glydrfreak/OpenPPG-SP-Throttle-EagleCAD/README.md

# OpenPPG-SP-Throttle-EagleCAD
Eagle CAD files for the OpenPPG Single Prop unit
