glydrfreak/OpenPPG-SP-Throttle-EagleCAD/BOM MAIN BOARD.xlsx

Qty | Value | Device | Package | Parts | Description | MPN
2 | 6.8pf | C-USC0402 | C0402 | C2, C4 | CAP CER 6.8PF 25V C0G/NP0 0402 | ‎GRM1555C1E6R8CA01D‎
2 | 1uf | C-USC0402 | C0402 | C3, C15 | CAP CER 1UF 25V X5R 0402 | GRM155R61E105KA12D‎
9 | .1uf | C-USC0402 | C0402 | C5, C6, C7, C10, C11, C12, C14, C17, C20 | CAP CER 0.1UF 25V X6S 0402 | GRM155C81E104KA12D‎
3 | 4.7uf | C-USC0402 | C0402 | C1, C8, C9 | CAP CER 4.7UF 10V X5R 0402 | GRM155R61A475MEAAD‎
1 | 10uf | C-USC0805 | C0805 | C21 | CAP CER 10UF 25V X5R 0805 | ‎TMK212BBJ106KG-T‎
2 | 22uf | C-USC0402 | C0603 | C18, C19 | CAP CER 22UF 10V X5R 0603 | ‎GRM188R61A226ME15D‎
1 | PRTR5V0U2X,215 | PRTR5V0U2X,215 | SOT143B | D1 | Ultra low capacitance double rail-to-rail ESD protection diode | PRTR5V0U2X,215
1 | MBR120ESFT1G | DIODE_SOD-123FL | SOD-123FL | D4 | Diode | MBR120ESFT1G
1 | BLM18PG471SN1D | FERRITE_BEAD | FERRITE_BEAD | FB | FERRITE BEAD 470 OHM 0603 1LN | BLM18PG471SN1D
1 | ‎BM06B-SRSS-TB(LF)(SN)‎ | ‎BM06B-SRSS-TB(LF)(SN)‎ | JST SH 1MM 6 PIN | J2 | JST SH 1MM VERT | ‎BM06B-SRSS-TB(LF)(SN)‎
1 | M20-7920542R | M20-7920542R | M20-7920542R | HP2 | CONN RCPT 10POS 0.1 GOLD SMD R/A | M20-7920542R
1 | ATSAMD21G18A-AF | ATSAMD21G18A-AF | QFP50P900X900X120-48N | IC1 | Cortex-M0+, 256KB FLASH, 32KB SRAM, USB, DMA, T&R - 48TQFP IND TEMP, GREEN, 1.6-3.6V, 48MHz | ‎ATSAMD21G18A-AF‎
1 | BMP388 | BMP388 | BMP388 | IC2 | ALTIMETER | BMP388
1 | CAT24C64WI-GT3 | CAT24C64WI-GT3 | SOIC127P600X175-8N | IC3 | 64 kb I2C CMOS Serial EEPROM | CAT24C64WI-GT3
1 | DRV2605 | DRV2605 | DRV2605 | IC4 | IC MOTOR DRIVER 2V-5.5V 10VSSOP | DRV2605LDGSR
1 | ‎AP63205WU-7‎ | 5V REGULATOR | TSOT26 | IC5 | IC REG BUCK 5V 2A TSOT26 | ‎AP63205WU-7‎
1 | ‎AP2114H-3.3TRG1‎ | 3.3V REGULATOR | SOT223 | IC8 | IC REG LINEAR 3.3V 1A SOT223 | ‎AP2114H-3.3TRG1‎
1 | 10118194-0001LF | 10118194-0001LF | FRAMATOME_10118194-0001LF | J1 | Conn Micro USB Type B RCP 5 POS 0.65mm Solder RA SMD 5 Terminal 1 Port T/R | 10118194-0001LF
1 | 4.7uH | INDUCTOR | L1812 | L1 | FIXED IND 4.7UH 1.6A 90 MOHM SMD | LQH43PN4R7M26L‎
1 | RED | LEDCHIP-LED0603 | CHIP-LED0603 | LED1 | LED | LTST-C191KRKT‎
1 | BLUE | LEDCHIP-LED0603 | CHIP-LED0603 | LED2 | LED | ‎LTST-C191TBKT‎
1 | CST-951RP-A | CST-951RP-A | CUI_CST-951RP-A | LS1 | 9 mm, 5 V, 85 dB, Through Hole, Side Port, Magnetic Audio Transducer Buzzer | CST-951RP-A
2 | SE14 | SE14 | SE14 | LSP1, LSP2 | Vibrating Mini Motor Disc | 1201
1 | 404R10KL1.0 | 404R10KL1.0 | 404R10KL1.0 | PT1 | POT SENSOR LINEAR 12.7MM SLD TURRET | 404R10KL1.0
1 | BC817-25LT1SMD | BC817-25LT1SMD | SOT23-BEC | Q1 | NPN Transistor | BC817-25LT1
5 | 1k | R-US_R0402 | R0402 | R1, R2, R3, R15, R18 | RES SMD 1K OHM 5% 1/16W 0402 | ‎RC0402JR-071KL‎
4 | 10k | R-US_R0402 | R0402 | R4, R5, R10, R14 | RES SMD 10K OHM 5% 1/16W 0402 | ‎RC0402JR-0710KL
4 | 4.7k | R-US_R0402 | R0402 | R7, R8, R11, R16 | RES SMD 4.7K OHM 5% 1/16W 0402 | ‎RC0402JR-074K7L
1 | 1M | R-US_R0402 | R0402 | R9 | RES SMD 1M OHM 5% 1/16W 0402 | RC0402JR-071ML‎
1 | KMR231NG LFS | TACTILE_SWITCH | TATILE_SWITCH | S3 | SWITCH TACTILE SPST-NO 0.05A 32V | KMR231NG LFS
1 | M50-3500542 | M50-3500542 | M50-3500542 | SWD1 | CONN HEADER VERT 10POS 1.27MM | M50-3500542
1 | ECS-.327-7-34B-TR | ECS-.327-7-34B-TR | XTAL_ECS-.327-12.5-34B-C-TR | Y1 | Crystal 2-SMD, No Lead | ECS-.327-7-34B-TR
6 |  |  |  | CABLE | CONN SOCKET 28-32AWG CRIMP TIN | ‎SSH-003T-P0.2
1 |  |  |  | CABLE | CBL RIBN 8COND 0.039 MULTI 5' | AWG28-08/F-1/300
1 |  |  |  | CABLE | CONN HOUSING SH 6POS 1MM WHITE | SHR-06V-S
2 |  |  |  | CABLE | CONN RCPT HSG 4POS 2.54MM | ‎M20-1060400
8 |  |  |  | CABLE | CONN SOCKET 22-30AWG CRIMP GOLD | M20-1160042‎
