glydrfreak/OpenPPG-SP-Throttle-EagleCAD/BOM SCREEN BOARD.xlsx

Qty | Value | Device | Package | Parts | Description | MPN
1 | 10uF | C-USC0805K | C0805K | C1 | CAPACITOR, American symbol | GRM21BR61E106MA73L
1 | M20-8760546 | M20-8760546 | M20-8760546 | HP1 |  | M20-8760546
1 | 2N2222 | MMBT2222ALT1-NPN-SOT23-BEC | SOT23-BEC | Q1 | NPN Transistror | ‎BC817-25LT1G
1 | 22 ohm | R-US_R0805 | R0805 | R1 | RESISTOR, American symbol | RC0805JR-0722RL
2 | 1K | R-US_R0805 | R0805 | R2, R3 | RESISTOR, American symbol | RC0805JR-071KL
1 | TL1105JAF250Q_1RBLK | TL1105JAF250Q_1RBLK | TL1105JAF250Q_1RBLK | SW1 | MOMENTARY SWITCH | 1825968-2
1 | JD-T1800 | JD-T1800 | JD-T1800 | U$1 | 1.8 INCH COLOR TFT | 618
1 |  |  |  |  | BUTTON CAP | 1RBLK
