glydrfreak/OpenPPG-SP-Throttle-EagleCAD/Main Board.brd

## EAGLE design Main Board.brd (2019-11-14)

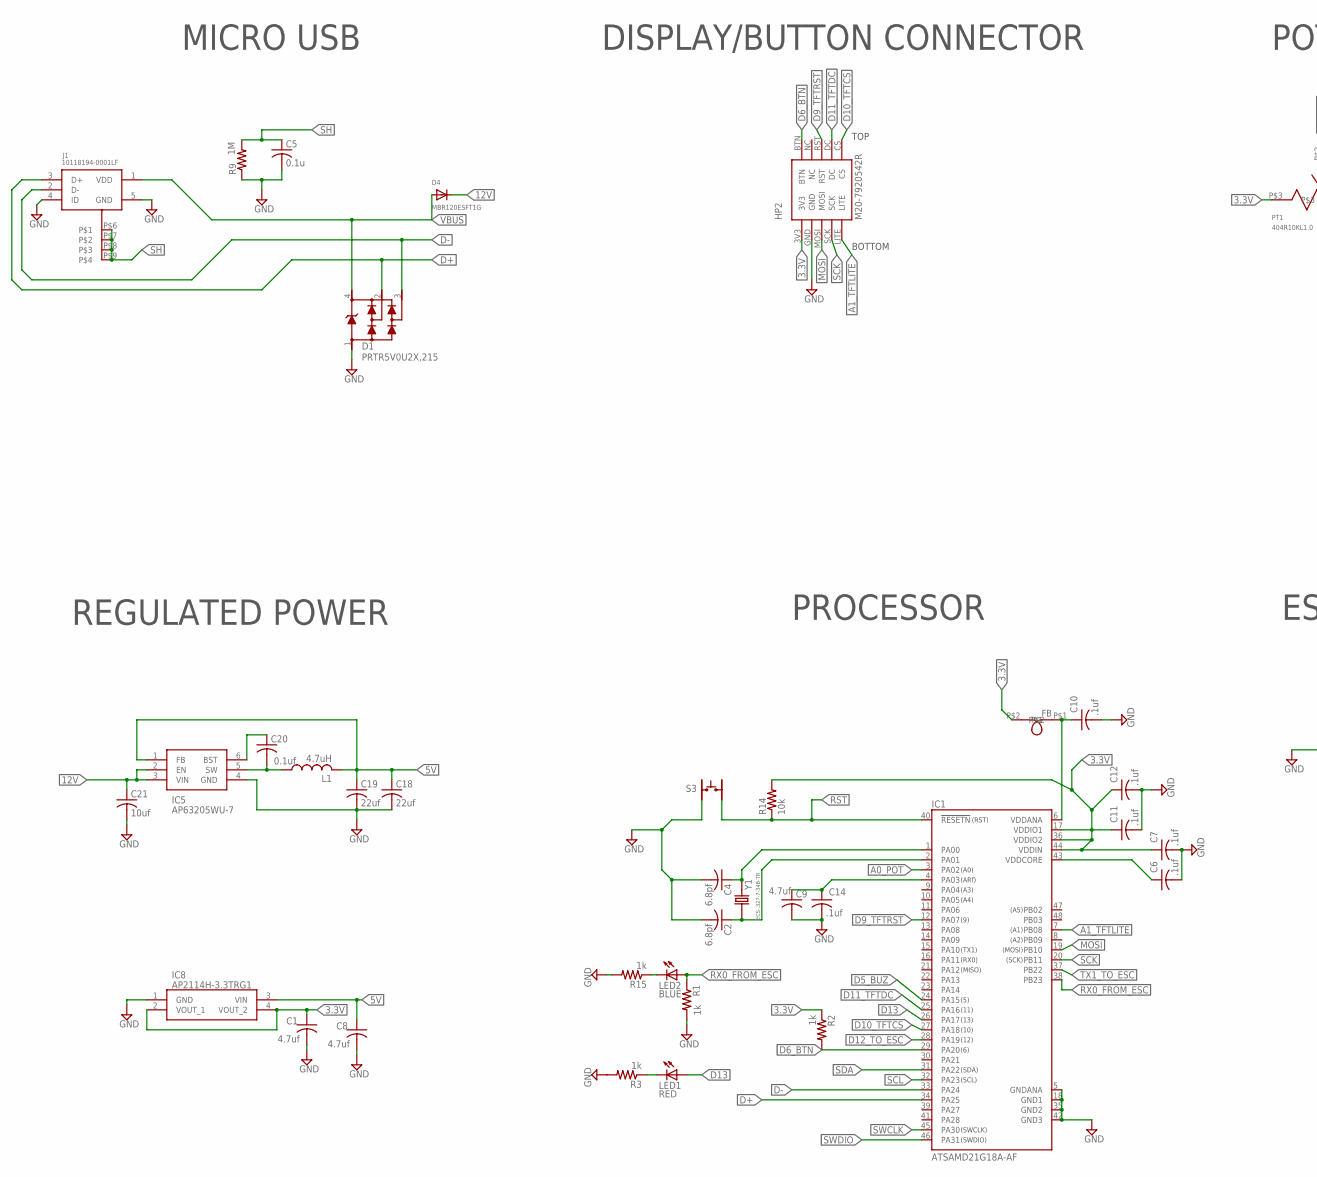
[picture p1: schematic Main Board.sch, part in row 1, column 1]

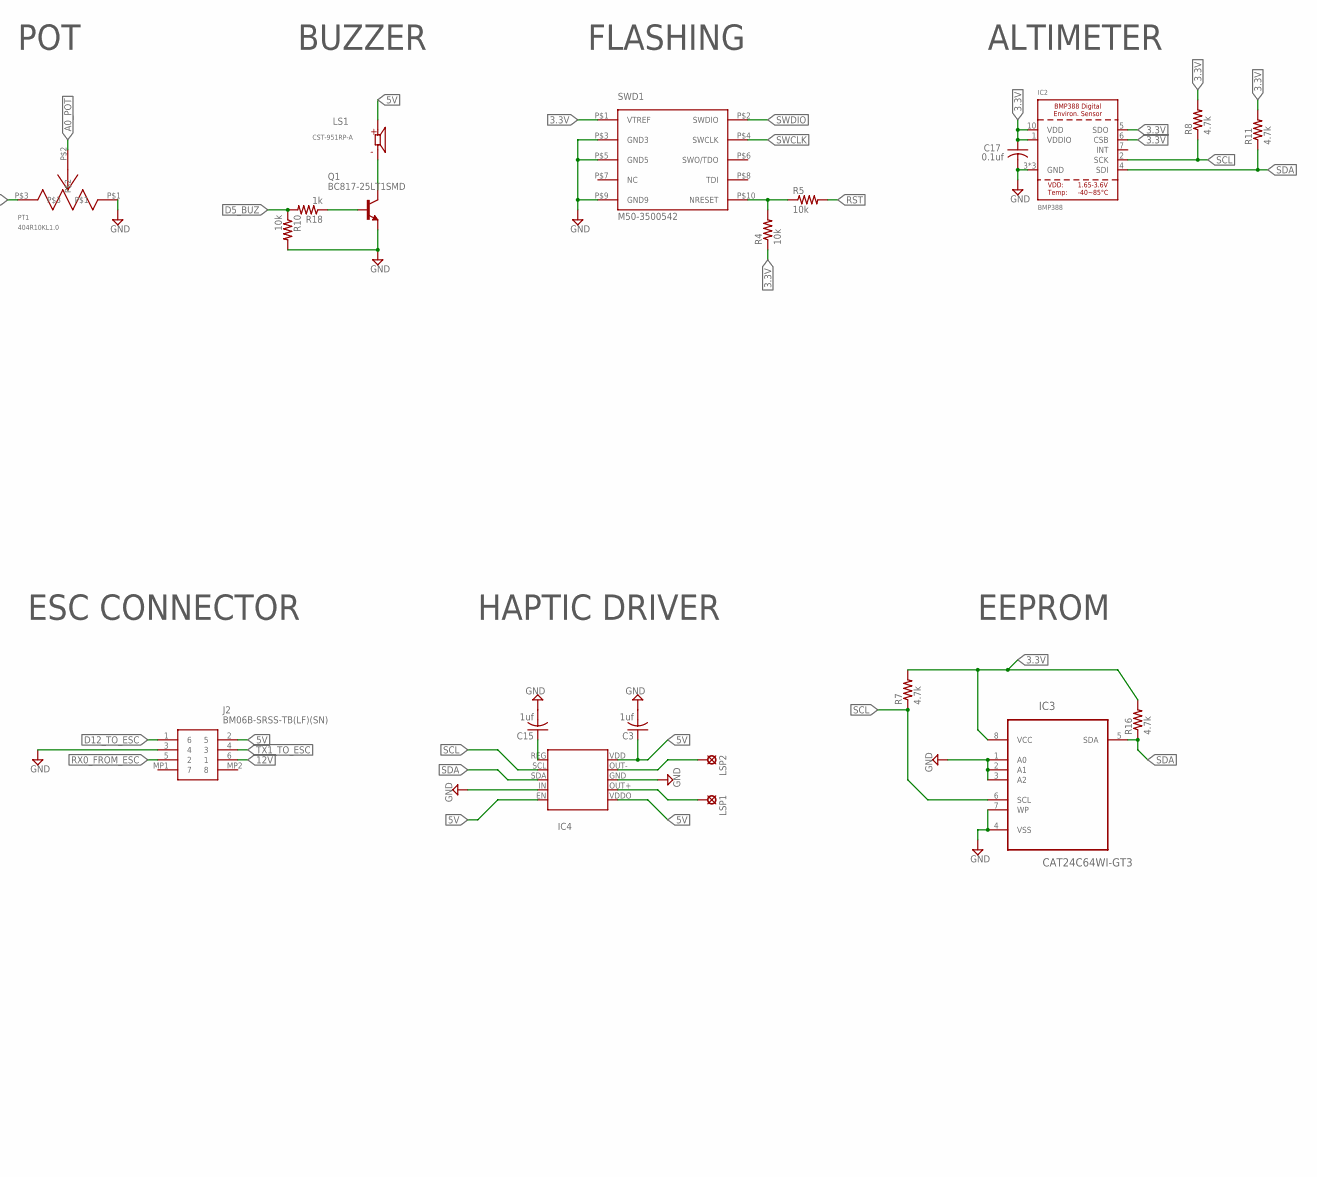
[picture p2: schematic Main Board.sch, part in row 1, column 2]

Parts:
C1, C8, C9: 4.7uf; C0402
C2, C4: 6.8pf; C0402
C3, C15: 1uf; C0402
C5: 0.1u; C0402
C6, C7, C10, C11, C12, C14: .1uf; C0402
C17, C20: 0.1uf; C0402
C18, C19: 22uf; C0603
C21: 10uf; C0805
D1: PRTR5V0U2X,215; SOT143B
D4: MBR120ESFT1G; SOD-123FL
FB: BLM18PG471SN1D; FERRITE_BEAD
HP2: M20-7920542R
IC1: ATSAMD21G18A-AF; QFP50P900X900X120-48N
IC2: BMP388
IC3: CAT24C64WI-GT3; SOIC127P600X175-8N
IC4: DRV2605
IC5: AP63205WU-7; SOT95P280X100-6N
IC8: AP2114H-3.3TRG1; SOT230P700X180-4N
J1: 10118194-0001LF; FRAMATOME_10118194-0001LF
J2: BM06B-SRSS-TB(LF)(SN); BM06BSRSSTBLFSN
L1: 4.7uH; L1812
LED1: RED; CHIP-LED0603
LED2: BLUE; CHIP-LED0603
LS1: CST-951RP-A; CUI_CST-951RP-A
LSP1, LSP2: SE14
PT1: 404R10KL1.0
Q1: BC817-25LT1SMD; SOT23-BEC
R1, R2, R3, R15, R18: 1k; R0402
R4, R5, R10, R14: 10k; R0402
R7, R8, R11, R16: 4.7k; R0402
R9: 1M; R0402
S3: KMR231NG LFS; TATILE_SWITCH
SWD1: M50-3500542
Y1: ECS-.327-7-34B-TR; XTAL_ECS-.327-12.5-34B-C-TR

Connections:
3.3V: C1.1, C7.1, C11.1, C12.1, C17.1, FB.P$2, HP2.3V3, IC1.17 (VDDIO1), IC1.36 (VDDIO2), IC1.44 (VDDIN), IC2.1 (VDDIO), IC2.5 (SDO), IC2.6 (CSB), IC2.10 (VDD), IC3.8 (VCC), IC8.2 (VOUT_1), IC8.4 (VOUT_2), PT1.P$3, R2.1, R4.1, R7.2, R8.2, R11.2, R14.2, R16.2, SWD1.P$1 (VTREF)
5V: C3.1, C8.1, C18.1, C19.1, IC4.EN, IC4.VDD, IC4.VDDO, IC5.1 (FB), IC8.3 (VIN), J2.2 (5), L1.2, LS1.P
12V: C21.1, D4.C, IC5.2 (EN), IC5.3 (VIN), J2.6 (1)
A0_POT: IC1.3 (PA02), PT1.P$2
A1_TFTLITE: HP2.LITE, IC1.7 (PB08)
D5_BUZ: IC1.24 (PA15), R10.1, R18.2
D6_BTN: HP2.BTN, IC1.29 (PA20), R2.2
D9_TFTRST: HP2.RST, IC1.12 (PA07)
D10_TFTCS: HP2.CS, IC1.27 (PA18)
D11_TFTDC: HP2.DC, IC1.25 (PA16)
D12_TO_ESC: IC1.28 (PA19), J2.1 (6)
D13: IC1.26 (PA17), LED1.A
D+: D1.2, IC1.34 (PA25), J1.3 (D+)
D-: D1.3, IC1.33 (PA24), J1.2 (D-)
GND: C1.2, C2.2, C3.2, C4.2, C5.2, C6.2, C7.2, C8.2, C9.2, C10.2, C11.2, C12.2, C14.2, C15.2, C17.2, C18.2, C19.2, C21.2, D1.1, HP2.GND, IC1.5 (GNDANA), IC1.18 (GND1), IC1.35 (GND2), IC1.42 (GND3), IC2.3 (GND), IC2.8 (GND), IC2.9 (GND), IC3.1 (A0), IC3.2 (A1), IC3.3 (A2), IC3.4 (VSS), IC3.7 (WP), IC4.GND, IC4.IN, IC5.4 (GND), IC8.1 (GND), J1.4 (ID), J1.5 (GND), J2.3 (4), PT1.P$1, Q1.E, R1.2, R3.2, R9.1, R10.2, R15.2, S3.P$3, SWD1.P$3 (GND3), SWD1.P$5 (GND5), SWD1.P$9 (GND9)
MOSI: HP2.MOSI, IC1.19 (PB10)
unnamed: C6.1, IC1.43 (VDDCORE)
unnamed: LED1.C, R3.1
unnamed: C4.1, IC1.1 (PA00), Y1.2
unnamed: C2.1, IC1.2 (PA01), Y1.1
unnamed: C10.1, FB.P$1, IC1.6 (VDDANA)
unnamed: R4.2, R5.1, SWD1.P$10 (NRESET)
unnamed: C20.2, IC5.5 (SW), L1.1
unnamed: C20.1, IC5.6 (BST)
unnamed: LED2.C, R15.1
unnamed: IC4.OUT-, LSP2.MP
unnamed: C9.1, C14.1, IC1.4 (PA03)
unnamed: Q1.B, R18.1
unnamed: LS1.M, Q1.C
unnamed: C15.1, IC4.REG
unnamed: IC4.OUT+, LSP1.MP
RST: IC1.40 (!RESETN), R5.2, R14.1, S3.P$4
RX0_FROM_ESC: IC1.38 (PB23), J2.5 (2), LED2.A, R1.1
SCK: HP2.SCK, IC1.20 (PB11)
SCL: IC1.32 (PA23), IC2.2 (SCK), IC3.6 (SCL), IC4.SCL, R7.1, R8.1
SDA: IC1.31 (PA22), IC2.4 (SDI), IC3.5 (SDA), IC4.SDA, R11.1, R16.1
SH: C5.1, J1.P$6, J1.P$7, J1.P$8, J1.P$9, R9.2
SWCLK: IC1.45 (PA30), SWD1.P$4 (SWCLK)
SWDIO: IC1.46 (PA31), SWD1.P$2 (SWDIO)
TX1_TO_ESC: IC1.37 (PB22), J2.4 (3)
VBUS: D1.4, D4.A, J1.1 (VDD)

Notes on the sheet:
POT
BUZZER
DISPLAY/BUTTON CONNECTOR
EEPROM
HAPTIC DRIVER
FLASHING
MICRO USB
PROCESSOR
ESC CONNECTOR
REGULATED POWER
ALTIMETER

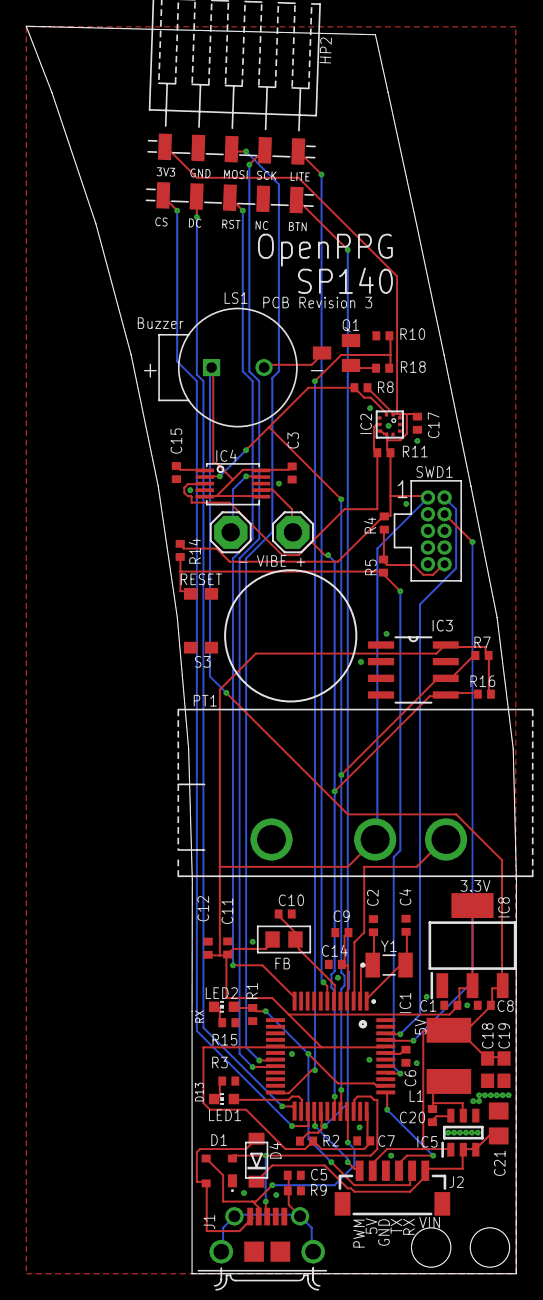
[picture p3: board Main Board.brd from above]

Board: 2 copper layers, 37.3 x 95.0 mm, 56 parts (0 on the bottom side), 41 nets.
