glydrfreak/OpenPPG-SP-Throttle-EagleCAD/Screen Board.brd

## EAGLE design Screen Board.brd (2019-08-27)

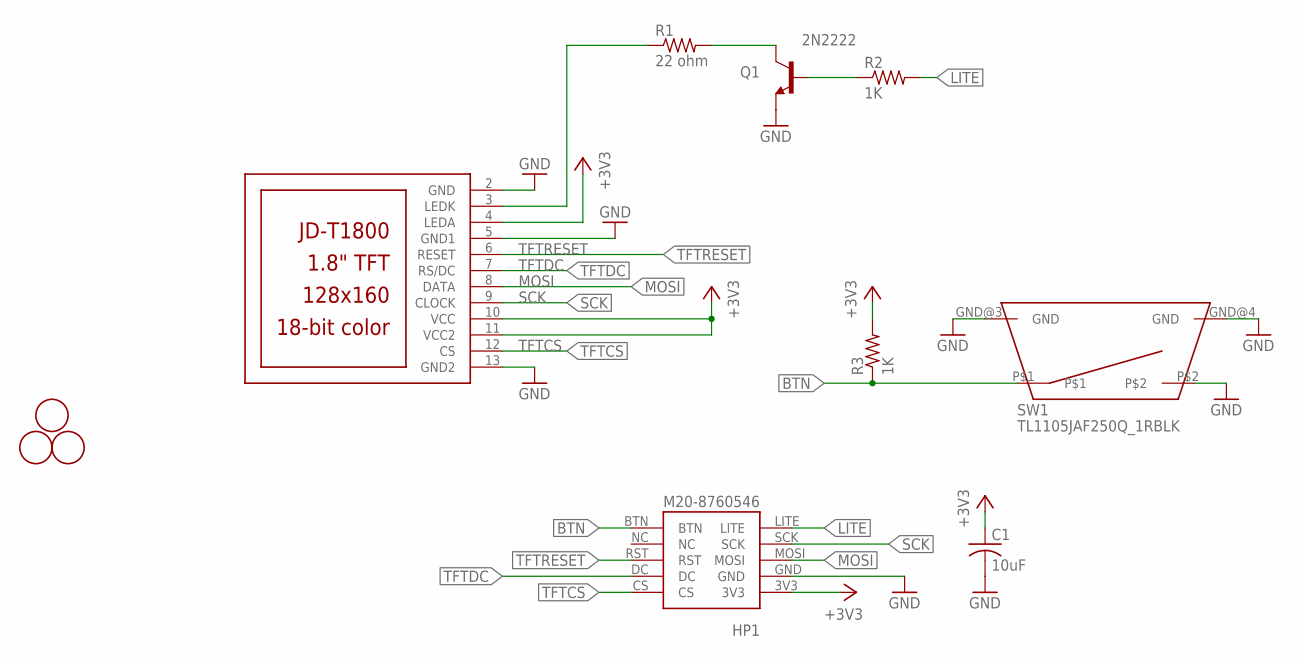
[picture p4: schematic Screen Board.sch]

Parts:
C1: 10uF; C0805K
HP1: M20-8760546
Q1: 2N2222; SOT23-BEC
R1: 22 ohm; R0805
R2, R3: 1K; R0805
SW1: TL1105JAF250Q_1RBLK
U$1: JD-T1800
U$3, U$4, U$5: FIDUCIAL; FIDUCIAL_1MM

Connections:
+3V3: C1.1, HP1.3V3, R3.2, U$1.4 (LEDA), U$1.10 (VCC), U$1.11 (VCC2)
BTN: HP1.BTN, R3.1, SW1.P$1
GND: C1.2, HP1.GND, Q1.E, SW1.GND@3 (GND), SW1.GND@4 (GND), SW1.P$2, U$1.2 (GND), U$1.5 (GND1), U$1.13 (GND2)
LITE: HP1.LITE, R2.2
MOSI: HP1.MOSI, U$1.8 (DATA)
unnamed: Q1.B, R2.1
unnamed: R1.1, U$1.3 (LEDK)
unnamed: Q1.C, R1.2
SCK: HP1.SCK, U$1.9 (CLOCK)
TFTCS: HP1.CS, U$1.12 (CS)
TFTDC: HP1.DC, U$1.7 (RS/DC)
TFTRESET: HP1.RST, U$1.6 (RESET)

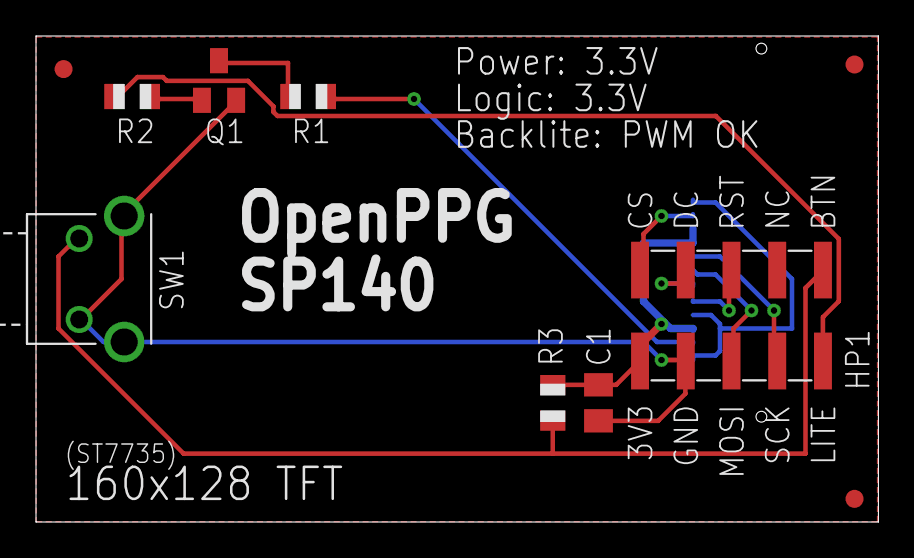
[picture p5: board Screen Board.brd from above]

Board: 2 copper layers, 46.8 x 27.0 mm, 11 parts (1 on the bottom side), 12 nets.
