glydrfreak/OpenPPG-SP-Throttle-EagleCAD/(commit log)

2019-08-20 6 pin SH connector instead of two 4 pin SH connectors
    [BOM MAIN BOARD.xlsx, Main Board.brd, Main Board.sch]
2019-08-27 Switching regulator to reduce heat, and added ground planes
    [BOM MAIN BOARD.xlsx, Main Board.brd, Main Board.sch, Screen Board.brd]
2019-08-27 Board Identifier SP140
    [Main Board.brd, Screen Board.brd]
2019-09-19 fixed C21 tplace silkscreen, fixed esc connector silkscreen spacing, fixed too big 0402 cap footprints
    [Main Board.brd]
2019-09-19 C21 tplace silkscreen, fixed esc connector silkscreen spacing, fixed too big 0402 cap footprints
2019-10-07 Rx and Tx to pin 37 and 38; Shifted location of JST; Added holes for zip tie
    [BOM MAIN BOARD.xlsx, Main Board.brd, Main Board.sch]
2019-10-07 Silkscreen fixes and added PCB revision label
    [Main Board.brd]
2019-10-08 Location of zip tie holes
    [Main Board.brd]
2019-11-14 adjusted location of zip tie holes
    [Main Board.brd]
